elliottgarner/plane-tracker/enclosure/encoder_knob.stl

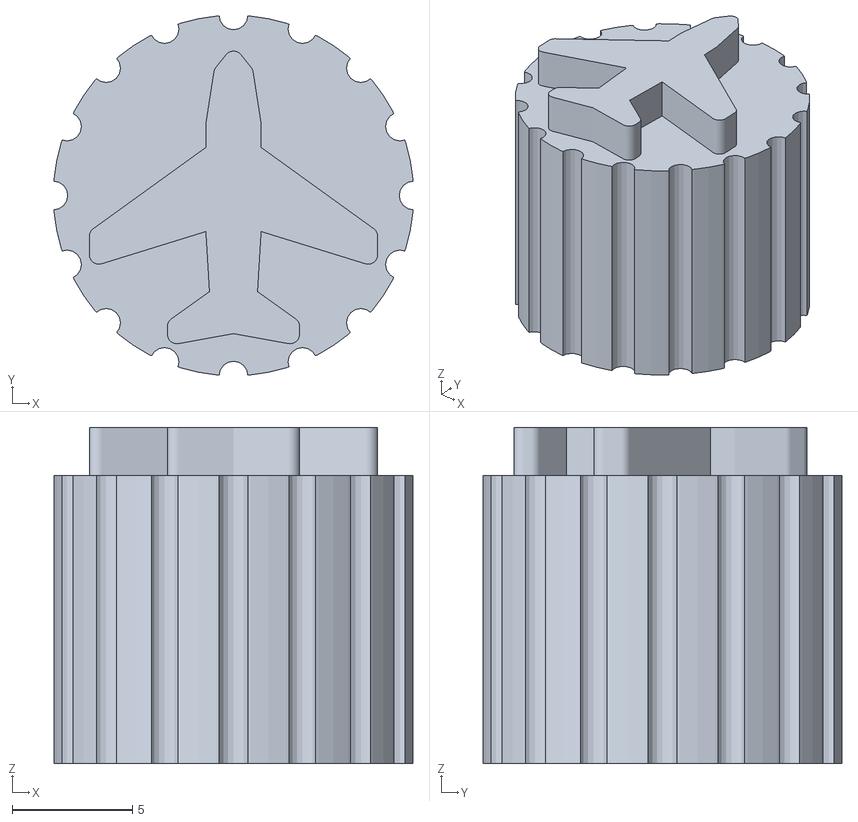
[picture p1: CAD file, 2026-10-29]
enclosure/encoder_knob.stl
14.9 x 14.9 x 14.0
