elliottgarner/plane-tracker/enclosure/all.stl

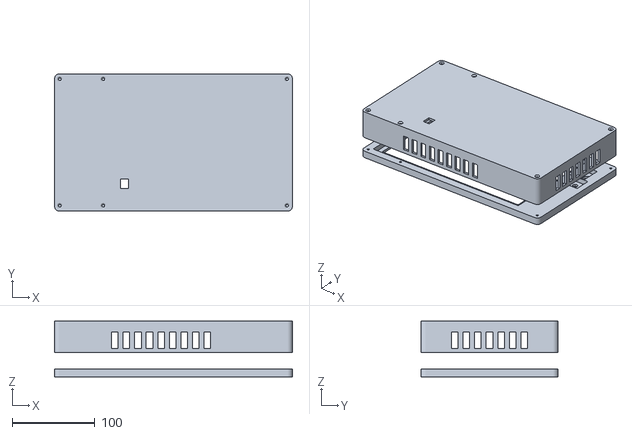
[picture p2: CAD file, 2026-10-29]
enclosure/all.stl
288.2 x 166.2 x 67.6
