elliottgarner/plane-tracker/enclosure/back.stl

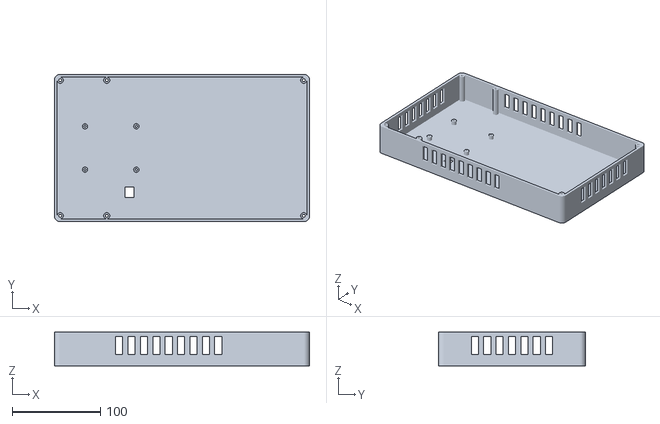
[picture p3: CAD file, 2026-10-29]
enclosure/back.stl
288.2 x 166.2 x 38.0
