elliottgarner/plane-tracker/enclosure/front.stl

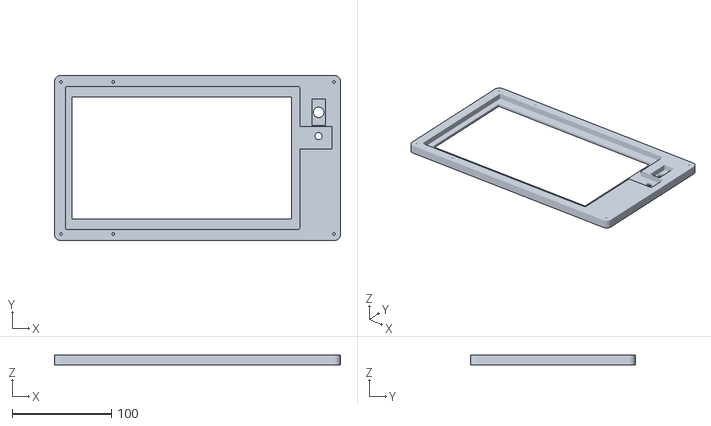
[picture p4: CAD file, 2026-10-29]
enclosure/front.stl
288.2 x 166.2 x 9.60
