elliottgarner/plane-tracker/enclosure/stand.stl

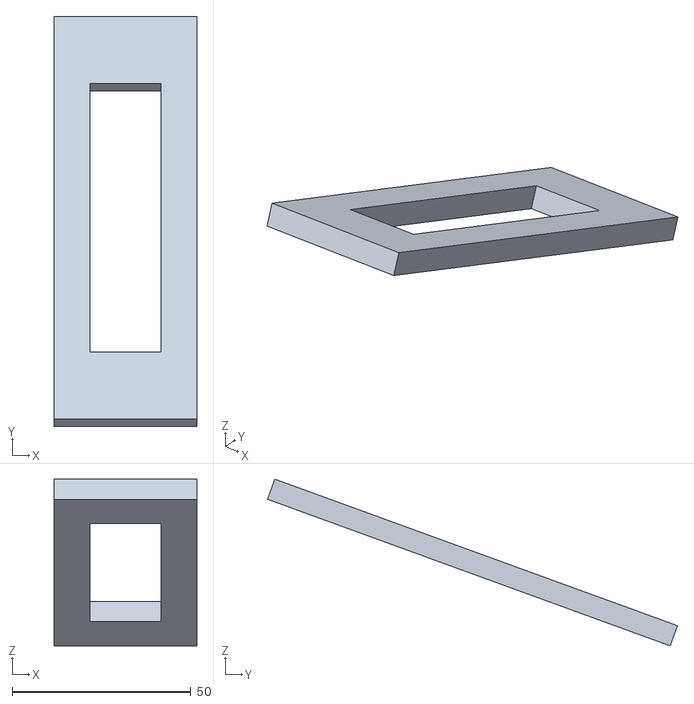
[picture p5: CAD file, 2026-10-27]
enclosure/stand.stl
40.0 x 114.8 x 46.7
