elliottgarner/plane-tracker/(list of files, cad)

Other CAD files:
enclosure/plane_tracker_enclosure.stl
