elliottgarner/plane-tracker/(commit log)

2026-10-27 GPIO updates
    [all.stl, back.stl, front.stl, plane_tracker_enclosure.scad, plane_tracker_enclosure.stl, stand.stl]
2026-10-28 Add optional panel power relay for screen sleep
    Blank then cut panel power on sleep, restore power and wait before
    unblanking on wake. Configurable GPIO, polarity and boot wait; off by
    default. Settings UI fields and README wiring row included.
2026-10-29 idk lol
    [all.stl, back.stl, bom.csv, encoder_knob.scad, encoder_knob.stl, front.stl, plane_tracker_enclosure.scad]
2026-10-30 Always hide the mouse pointer on the dashboard
    The pointer no longer reappears on mouse movement or over buttons and
    markers. Pressing 'c' still toggles it for debugging.
2026-10-31 Add saved locations, switched by a 10 s encoder-button hold or from Settings
    Locations (name, lat/lon, elevation, range) live in data/locations.json. A hold of
    location_hold_seconds on the encoder button cycles to the next one and shows an
    on-screen notice. Short and long (map/stats) presses now act on release so the
    long hold does not also flip the view.
    [config.py, hardware_controls.py, locations.py, main.py]
2026-10-31 Add hexdb.io fallback for unknown routes and explain why a route is missing
    When the VRS list has no entry for a callsign, ask hexdb.io (route_fallback_url,
    blank to disable); both airports must be known and the usual plausibility check
    still applies. The card now says military / private flight instead of just
    'route unknown' when that is the reason.
    [config.py, enricher.py, main.py]
2026-10-31 Infer landing / departure airfield for planes with no flight plan
    Low and descending towards an airfield shows 'landing at', first seen climbing out
    of one shows 'departed', both labelled (inferred). Uses any airfield size, so
    microlight and GA strips count. Real routes always win.
2026-10-31 Reject a listed route when the plane is climbing away from its 'destination'
    Reused callsigns (e.g. RYR27MC: DUB-MAN inbound vs MAN departure) passed the
    plausibility check because the heading test is skipped near the destination.
    A hard climb beside the destination now fails it, and a rejected route triggers
    a second-source (hexdb.io) lookup that is used if it fits the flight path.
    [enricher.py, tracker.py]
2026-10-31 Wrap the route status line instead of overflowing the airport boxes
    The line under the route bar was nowrap, so long text ('listed route doesn't
    match flight path', inferred landing messages) spilled over its neighbours.
    Let it wrap, let the grid cells shrink, and shorten the inferred label since the
    airport already shows beside it.
2026-10-31 Settings page: section jump bar, unsaved-changes tracking, save error handling
    Fix invalid button font shorthand, add sticky section nav, disable Save until
    something changes, warn before discarding edits, Ctrl+S to save, and report an
    unreachable Pi instead of failing silently.
2026-10-31 Boost high, fast airline flights so they take focus from GA circuits
    A scheduled-style callsign at or above carrier_min_alt_ft and carrier_min_gs_kt gets
    carrier_bonus added to its rank (not to the interest score, so the 'interesting'
    filter is unaffected). Tunable in Settings; 0 disables.
